rasheeddo/DynamixelServoGimbal/2AxesDynamixelServoGimbal.py

import time
from mpu6050 import mpu6050                      #new library for IMU
import math
from dynamixel_sdk import *                     # Uses Dynamixel SDK library
import threading


######################### Dynamixel Define, variable and function
ADDR_PRO_BAUDRATE           = 8

ADDR_PRO_TORQUE_ENABLE      = 64               
ADDR_PRO_GOAL_POSITION      = 116
ADDR_PRO_PRESENT_POSITION   = 132

ADDR_PRO_CURRENT_LIMIT      = 38
ADDR_PRO_GOAL_CURRENT       = 102
ADDR_PRO_PRESENT_CURRENT    = 126 

ADDR_PRO_OPERATING_MODE     = 11

ADDR_PRO_GOAL_VELOCITY      = 104

ADDR_PRO_ACCELERATION_LIMIT = 40
ADDR_PRO_VELOCITY_LIMIT     = 44
ADDR_PRO_PROFILE_ACCELERATION  = 108
ADDR_PRO_PROFILE_VELOCITY   = 112

ADDR_PRO_POSITION_D_GAIN    = 80
ADDR_PRO_POSITION_I_GAIN    = 82
ADDR_PRO_POSITION_P_GAIN    = 84
ADDR_PRO_FEEDFORWARD_2nd_GAIN = 88
ADDR_PRO_FEEDFORWARD_1st_GAIN = 90

ADDR_PRO_MOVING             = 122
ADDR_PRO_MOVING_STATUS       = 123

CURRENT_CONTROL                     = 0
POSITION_CONTROL                    = 3 # Default
CURRENT_BASED_POSITION_CONTROL      = 5
# Protocol version
PROTOCOL_VERSION            = 2.0               # See which protocol version is used in the Dynamixel

# Default setting
DXL1_ID                      = 1                             # Dynamixel ID: 1
DXL2_ID                      = 2                             # Dynamixel ID: 2
DXL3_ID                      = 3                             # Dynamixel ID: 3
DXL4_ID                      = 4
DXL5_ID                      = 5
DXL6_ID                      = 6



BAUDRATE                    = 57600            # Dynamixel default baudrate : 57600
DEVICENAME                  = '/dev/ttyUSB0'    # Check which port is being used on your controller
                                                # ex) Windows: "COM1"   Linux: "/dev/ttyUSB0" Mac: "/dev/tty.usbserial-*"
TORQUE_ENABLE               = 1                 # Value for enabling the torque
TORQUE_DISABLE              = 0                 # Value for disabling the torque

def RunServo(DEG1,DEG2):
    servo_ang1 = map(DEG1, 0.0, 360.0, 0, 4095)
    servo_ang2 = map(DEG2, 0.0, 360.0, 0, 4095)

    dxl1_goal_position = int(servo_ang1)
    dxl2_goal_position = int(servo_ang2)
    

    dxl_comm_result1, dxl_error1 = packetHandler.write4ByteTxRx(portHandler, DXL1_ID, ADDR_PRO_GOAL_POSITION, dxl1_goal_position)
    dxl_comm_result2, dxl_error2 = packetHandler.write4ByteTxRx(portHandler, DXL2_ID, ADDR_PRO_GOAL_POSITION, dxl2_goal_position)

def RunServo1(inputDeg1):
    pos1 = inputDeg1
    servo_com1 = map(pos1,0.0,360.0,0.0,4095.0)
    dxl1_goal_position = int(servo_com1)
    dxl_comm_result1, dxl_error1 = packetHandler.write4ByteTxRx(portHandler, DXL1_ID, ADDR_PRO_GOAL_POSITION, dxl1_goal_position)
    print ("RunServo1")
    if dxl_comm_result1 != COMM_SUCCESS:
        print("%s" % packetHandler.getTxRxResult(dxl_comm_result1))
    elif dxl_error1 != 0:
        print("%s" % packetHandler.getRxPacketError(dxl_error1))

def RunServo2(inputDeg2):
    pos2 = inputDeg2
    servo_com2 = map(pos2,0.0,360.0,0.0,4095.0)
    dxl2_goal_position = int(servo_com2)
    dxl_comm_result2, dxl_error2 = packetHandler.write4ByteTxRx(portHandler, DXL2_ID, ADDR_PRO_GOAL_POSITION, dxl2_goal_position)
    print ("RunServo2")
    if dxl_comm_result2 != COMM_SUCCESS:
        print("%s" % packetHandler.getTxRxResult(dxl_comm_result2))
    elif dxl_error2 != 0:
        print("%s" % packetHandler.getRxPacketError(dxl_error2))

def ReadAngle12():
    dxl_present_position1, dxl_comm_result, dxl_error = packetHandler.read4ByteTxRx(portHandler, DXL1_ID, ADDR_PRO_PRESENT_POSITION)
    dxl_present_position2, dxl_comm_result, dxl_error = packetHandler.read4ByteTxRx(portHandler, DXL2_ID, ADDR_PRO_PRESENT_POSITION)   
    pre_pos1 = map(dxl_present_position1, 0.0, 4095.0, 0.0, 360.0)
    pre_pos2 = map(dxl_present_position2, 0.0, 4095.0, 0.0, 360.0)

    return pre_pos1,pre_pos2

def GoHome12():
   
    servo_ang1 = map(140, 0.0, 360.0, 0, 4095)
    servo_ang2 = map(135, 0.0, 360.0, 0, 4095)
    

    dxl1_goal_position = servo_ang1  
    dxl2_goal_position = servo_ang2

    dxl_comm_result1, dxl_error1 = packetHandler.write4ByteTxRx(portHandler, DXL1_ID, ADDR_PRO_GOAL_POSITION, int(dxl1_goal_position))
    dxl_comm_result2, dxl_error2 = packetHandler.write4ByteTxRx(portHandler, DXL2_ID, ADDR_PRO_GOAL_POSITION, int(dxl2_goal_position))

def SetOperationMode(MODE):
    TorqueOff()
    dxl_comm_result, dxl_error = packetHandler.write1ByteTxRx(portHandler, DXL1_ID, ADDR_PRO_OPERATING_MODE, MODE)
    dxl_comm_result, dxl_error = packetHandler.write1ByteTxRx(portHandler, DXL2_ID, ADDR_PRO_OPERATING_MODE, MODE)
    
def CheckOperationMode():
    present_mode, dxl_comm_result, dxl_error = packetHandler.read1ByteTxRx(portHandler, DXL1_ID, ADDR_PRO_OPERATING_MODE)
    present_mode, dxl_comm_result, dxl_error = packetHandler.read1ByteTxRx(portHandler, DXL2_ID, ADDR_PRO_OPERATING_MODE)
    if present_mode == 0:
        # Current (Torque) Control Mode
        print("Now Operating Mode is Torque Control")
    elif present_mode == 3:
        # Position Control Mode
        print("Now Operating Mode is Position Control")
    elif present_mode == 5:
        # Current-based Position Control Mode
        print("Now Operating Mode is Current-based Position Control")
    else:
        print("In other Mode that didn't set!")

def TorqueOn():
    dxl_comm_result, dxl_error = packetHandler.write1ByteTxRx(portHandler, DXL1_ID, ADDR_PRO_TORQUE_ENABLE, TORQUE_ENABLE)
    dxl_comm_result, dxl_error = packetHandler.write1ByteTxRx(portHandler, DXL2_ID, ADDR_PRO_TORQUE_ENABLE, TORQUE_ENABLE)
    print("Enable Toruqe...")

def TorqueOff():
    dxl_comm_result, dxl_error = packetHandler.write1ByteTxRx(portHandler, DXL1_ID, ADDR_PRO_TORQUE_ENABLE, TORQUE_DISABLE)
    dxl_comm_result, dxl_error = packetHandler.write1ByteTxRx(portHandler, DXL2_ID, ADDR_PRO_TORQUE_ENABLE, TORQUE_DISABLE)
    print("Disable Toruqe...")
    

def SetProfile1(set_V_PRFL,set_A_PRFL):
    ######################### Set Velocity / Acceleration Profile  ##############################
    set_A_Limit = 32767     # 32767 default                [214.577 rev/min^2]
    set_V_Limit = 1023       # 350 Default                  [0.229RPM]

    dxl_comm_result, dxl_error = packetHandler.write4ByteTxRx(portHandler, DXL1_ID, ADDR_PRO_ACCELERATION_LIMIT, set_A_Limit)
    dxl_comm_result, dxl_error = packetHandler.write4ByteTxRx(portHandler, DXL1_ID, ADDR_PRO_VELOCITY_LIMIT, set_V_Limit)

    dxl_comm_result, dxl_error = packetHandler.write4ByteTxRx(portHandler, DXL1_ID, ADDR_PRO_PROFILE_ACCELERATION, int(set_A_PRFL))
    dxl_comm_result, dxl_error = packetHandler.write4ByteTxRx(portHandler, DXL1_ID, ADDR_PRO_PROFILE_VELOCITY, int(set_V_PRFL))

    acceleration_limit, dxl_comm_result, dxl_error = packetHandler.read4ByteTxRx(portHandler, DXL1_ID, ADDR_PRO_ACCELERATION_LIMIT)
    velocity_limit, dxl_comm_result, dxl_error = packetHandler.read4ByteTxRx(portHandler, DXL1_ID, ADDR_PRO_VELOCITY_LIMIT)

    print("V PRFL 1: %d" %set_V_PRFL)
    print("A PRFL 1: %d" %set_A_PRFL)
    print("--------------------------------")

def SetProfile2(set_V_PRFL,set_A_PRFL):
    ######################### Set Velocity / Acceleration Profile  ##############################
    set_A_Limit = 32767     # 32767 default                [214.577 rev/min^2]
    set_V_Limit = 1023      # 350 Default                  [0.229RPM]

    #set_A_PRFL = 30      # between 0 ~ set_A_limit      [214.577 rev/min^2]
    #set_V_PRFL = 200      # between 0 ~ set_V_Limit      [0.229RPM]

    dxl_comm_result, dxl_error = packetHandler.write4ByteTxRx(portHandler, DXL2_ID, ADDR_PRO_ACCELERATION_LIMIT, set_A_Limit)
    dxl_comm_result, dxl_error = packetHandler.write4ByteTxRx(portHandler, DXL2_ID, ADDR_PRO_VELOCITY_LIMIT, set_V_Limit)

    dxl_comm_result, dxl_error = packetHandler.write4ByteTxRx(portHandler, DXL2_ID, ADDR_PRO_PROFILE_ACCELERATION, int(set_A_PRFL))
    dxl_comm_result, dxl_error = packetHandler.write4ByteTxRx(portHandler, DXL2_ID, ADDR_PRO_PROFILE_VELOCITY, int(set_V_PRFL))

    acceleration_limit, dxl_comm_result, dxl_error = packetHandler.read4ByteTxRx(portHandler, DXL2_ID, ADDR_PRO_ACCELERATION_LIMIT)
    velocity_limit, dxl_comm_result, dxl_error = packetHandler.read4ByteTxRx(portHandler, DXL2_ID, ADDR_PRO_VELOCITY_LIMIT)

    print("V PRFL 2: %d" %set_V_PRFL)
    print("A PRFL 2: %d" %set_A_PRFL)
    print("--------------------------------") 

def SetPID1(set_P_Gain,set_I_Gain,set_D_Gain):
    
    dxl_comm_result, dxl_error = packetHandler.write2ByteTxRx(portHandler, DXL1_ID, ADDR_PRO_POSITION_P_GAIN, set_P_Gain)
    dxl_comm_result, dxl_error = packetHandler.write2ByteTxRx(portHandler, DXL1_ID, ADDR_PRO_POSITION_I_GAIN, set_I_Gain)
    dxl_comm_result, dxl_error = packetHandler.write2ByteTxRx(portHandler, DXL1_ID, ADDR_PRO_POSITION_D_GAIN, set_D_Gain)

    time.sleep(0.5)
    
    position_D_gain, dxl_comm_result, dxl_error = packetHandler.read2ByteTxRx(portHandler, DXL1_ID, ADDR_PRO_POSITION_D_GAIN)
    position_I_gain, dxl_comm_result, dxl_error = packetHandler.read2ByteTxRx(portHandler, DXL1_ID, ADDR_PRO_POSITION_I_GAIN)
    position_P_gain, dxl_comm_result, dxl_error = packetHandler.read2ByteTxRx(portHandler, DXL1_ID, ADDR_PRO_POSITION_P_GAIN)

    print("Position P Gain 1: %d" %position_P_gain)
    print("Position I Gain 1: %d" %position_I_gain)
    print("Position D Gain 1: %d" %position_D_gain)
    print("------------------------------")

def SetPID2(set_P_Gain,set_I_Gain,set_D_Gain):
    dxl_comm_result, dxl_error = packetHandler.write2ByteTxRx(portHandler, DXL2_ID, ADDR_PRO_POSITION_P_GAIN, set_P_Gain)
    dxl_comm_result, dxl_error = packetHandler.write2ByteTxRx(portHandler, DXL2_ID, ADDR_PRO_POSITION_I_GAIN, set_I_Gain)
    dxl_comm_result, dxl_error = packetHandler.write2ByteTxRx(portHandler, DXL2_ID, ADDR_PRO_POSITION_D_GAIN, set_D_Gain)

    time.sleep(0.5)

    position_D_gain, dxl_comm_result, dxl_error = packetHandler.read2ByteTxRx(portHandler, DXL2_ID, ADDR_PRO_POSITION_D_GAIN)
    position_I_gain, dxl_comm_result, dxl_error = packetHandler.read2ByteTxRx(portHandler, DXL2_ID, ADDR_PRO_POSITION_I_GAIN)
    position_P_gain, dxl_comm_result, dxl_error = packetHandler.read2ByteTxRx(portHandler, DXL2_ID, ADDR_PRO_POSITION_P_GAIN)

    print("Position P Gain 2: %d" %position_P_gain)
    print("Position I Gain 2: %d" %position_I_gain)
    print("Position D Gain 2: %d" %position_D_gain)
    print("------------------------------")

def SetFFGain1(set_FF1_Gain,set_FF2_Gain):
    dxl_comm_result, dxl_error = packetHandler.write2ByteTxRx(portHandler, DXL1_ID, ADDR_PRO_FEEDFORWARD_1st_GAIN, set_FF1_Gain)
    dxl_comm_result, dxl_error = packetHandler.write2ByteTxRx(portHandler, DXL1_ID, ADDR_PRO_FEEDFORWARD_2nd_GAIN, set_FF2_Gain)

    FF1_gain, dxl_comm_result, dxl_error = packetHandler.read2ByteTxRx(portHandler, DXL1_ID, ADDR_PRO_FEEDFORWARD_1st_GAIN)
    FF2_gain, dxl_comm_result, dxl_error = packetHandler.read2ByteTxRx(portHandler, DXL1_ID, ADDR_PRO_FEEDFORWARD_2nd_GAIN)

    print("Feedforward 1st Gain 1: %d" %FF1_gain)
    print("Feedforward 2nd Gain 1: %d" %FF2_gain)
    print("------------------------------") 

def SetFFGain2(set_FF1_Gain,set_FF2_Gain):
    dxl_comm_result, dxl_error = packetHandler.write2ByteTxRx(portHandler, DXL2_ID, ADDR_PRO_FEEDFORWARD_1st_GAIN, set_FF1_Gain)
    dxl_comm_result, dxl_error = packetHandler.write2ByteTxRx(portHandler, DXL2_ID, ADDR_PRO_FEEDFORWARD_2nd_GAIN, set_FF2_Gain)

    FF1_gain, dxl_comm_result, dxl_error = packetHandler.read2ByteTxRx(portHandler, DXL2_ID, ADDR_PRO_FEEDFORWARD_1st_GAIN)
    FF2_gain, dxl_comm_result, dxl_error = packetHandler.read2ByteTxRx(portHandler, DXL2_ID, ADDR_PRO_FEEDFORWARD_2nd_GAIN)

    print("Feedforward 1st Gain 2: %d" %FF1_gain)
    print("Feedforward 2nd Gain 2: %d" %FF2_gain)
    print("------------------------------")


########################## IMU define, variable 

period = 0 # initial value of period

sensor = mpu6050(0x68)

rawXoffset=0
rawYoffset=0
rawZoffset=0
rawXpoffset=0
rawYpoffset=0
rawZpoffset=0
#Variable for Kalman filter:
init=1
k_r=0.980 
k_p=0.995

Kpitch=0
Kroll=0
Kyaw=0
#Variable for the smoother function:
initSmooth=1
avPitch=[]
avRoll=[]
avYaw=[]

### Rasheed's method
init3 = 1
Dt = 0.02
global kr, kp
kr = 0.99
kp = 0.99
roll3= []
pitch3=[]

last_roll = 0
last_pitch = 0

#P_offset,R_offset = FindOffsetAngle()   

def AverageData(scale,pitch,roll):

    Buff_P = list()
    Buff_R = list()

    for i in range(0,scale):
        Buff_P.append(pitch)
        Buff_R.append(roll)

        if i == (scale-1):
            Ave_Pitch = sum(Buff_P)/len(Buff_P)
            Ave_Roll = sum(Buff_R)/len(Buff_R)
            Buff_P = list()
            Buff_R = list()

    return Ave_Pitch, Ave_Roll

def map(val, in_min, in_max, out_min, out_max):

    return (val - in_min) * (out_max - out_min) / (in_max - in_min) + out_min

def getIMU3(updateTime):
    global init3, pitch_out, roll_out
    Dt=updateTime
    acc_data = sensor.get_accel_data()
    gyro_data=sensor.get_gyro_data()

    accX=acc_data["x"]
    accY=acc_data["y"]
    accZ=acc_data["z"]
    gyroX=gyro_data["x"] - GyroXcal
    gyroY=gyro_data["y"] - GyroYcal
    gyroZ=gyro_data["z"] - GyroZcal

    #Angle calculation by axelerometer
    roll_acc = math.degrees(math.atan(accY/math.sqrt(math.pow(accX,2)+math.pow(accZ,2))))
    pitch_acc = math.degrees(math.atan(-accX/math.sqrt(math.pow(accY,2)+math.pow(accZ,2))))
    #yawA=m.degrees((m.atan(m.sqrt(m.pow(accX,2)+m.pow(accY,2)),rawZ)))
    
    if (init3):
        roll_gyro = roll_acc
        pitch_gyro = pitch_acc
        init3 = 0
    else:
        roll_gyro = Dt*gyroX + roll_out
        pitch_gyro = Dt*gyroY + pitch_out
    

    roll_out = kr*roll_gyro + (1-kr)*roll_acc
    pitch_out = kp*pitch_gyro + (1-kp)*pitch_acc
    print("Roll", roll_out)
    print("Pitch", pitch_out)
    return roll_out, pitch_out

def getRawGyro():
    giroscope_data=sensor.get_gyro_data()
    rawXp=giroscope_data["x"]
    rawYp=giroscope_data["y"]
    rawZp=giroscope_data["z"]
    return rawXp, rawYp, rawZp

def RawGyroCalibration():
    print("Doing gyro calibration...(Keep stable!)")
    gyroX = []
    gyroY = []
    gyroZ = [] 
    for i in range(0,500):
        rawGyro = getRawGyro()
        gyroX.append(rawGyro[0])
        gyroY.append(rawGyro[1])
        gyroZ.append(rawGyro[2])
        time.sleep(0.01)

    ave_gyroX = sum(gyroX)/len(gyroX)
    ave_gyroY = sum(gyroY)/len(gyroY)
    ave_gyroZ = sum(gyroZ)/len(gyroZ)

    return ave_gyroX, ave_gyroY, ave_gyroZ
   
##############################################################################
##Initialization
#Motors 
portHandler = PortHandler(DEVICENAME)
packetHandler = PacketHandler(PROTOCOL_VERSION)
if portHandler.openPort():
    print("Succeeded to open the port")
else:
    print("Failed to open the port")
    print("Press any key to terminate...")
    getch()
    quit()
if portHandler.setBaudRate(BAUDRATE):
    print("Succeeded to change the baudrate")
else:
    print("Failed to change the baudrate")
    print("Press any key to terminate...")
    getch()
    quit()
    


SetProfile1(0,0)
SetProfile2(0,0)
SetPID1(800,1000,0)
SetPID2(800,1000,0)
time.sleep(0.5)

TorqueOn()
time.sleep(0.5)
GoHome12()
time.sleep(2)

#Serial Communication
ser = serial.Serial('/dev/ttyACM0',9600)
ser.flushInput()

lastS0 = 1500
lastS1 = 1180

time.sleep(1)
#Accelerometer:
gyroCal = RawGyroCalibration()
global GyroXcal, GyroYcal, GyroZcal
GyroXcal = gyroCal[0]
GyroYcal = gyroCal[1]
GyroZcal = gyroCal[2]
#Semaphore
sem = threading.Semaphore()
mode=1180
tilt=1500

##############################################################################
#Thread functions  
def ReadSerial():
    global mode, tilt
    data=[]
    while 1:
        data = ser.readline()
        DATA = list(data)

        if len(DATA) == 11:
            DataCh1 = [DATA[0],DATA[1],DATA[2],DATA[3]]
            DataCh2 = [DATA[5],DATA[6],DATA[7],DATA[8]]
            Ch1 = "".join(DataCh1)
            Ch2 = "".join(DataCh2)
            if Ch1.isdigit() and Ch2.isdigit():
                stick = int(Ch1)
                switch = int(Ch2)
                #print ("Ch1: %d" %stick)
                #print ("Ch2: %d" %switch)
                control_ang = map(stick,1088,1920,-1.0,1.0)
                #We write in the variable protected with a semaphore
                sem.acquire()
                mode=switch
                tilt=control_ang
                sem.release()
                #print("\n")
                #print("Mode :", mode)
                #print("tilt", tilt)
                #print("\n")
            else:
                print("NA")            
        else:
            print ("Trash Data")
    #time.sleep(0.01)
            
normal_roll = 140
normal_pitch = 135
period = 0

def RunGimbal():
    global mode, tilt, period
    #Read the variable protected with a semaphore
    modeRun = 0
    tiltRun = 0
    while 1:
        startTime = time.time()
        sem.acquire()
        print("update Value")
        modeRun=mode
        tiltRun=tilt
        sem.release()
        rollDegree, pitchDegree = getIMU3(period)
        if abs(tiltRun) < 0.05:
            tiltRun = 0.00
        ## Only stabilizer mode
        if modeRun < 1200:
            #rollDegree, pitchDegree = getIMU3()
            ServoAng1 = normal_roll - rollDegree 
            ServoAng2 = normal_pitch - pitchDegree
        ## Tilt manual control
        elif modeRun > 1400 and modeRun < 1550:
            ServoAng1 = normal_roll - rollDegree 
            ServoAng2 = normal_pitch + (80*tiltRun)
            # Set new pitch angle
            new_pitch = normal_pitch + (80*tiltRun)
        ## Use new pitch angle on stabilize mode
        elif modeRun > 1800:
            #rollDegree, pitchDegree = getIMU3()
            ServoAng1 = normal_roll - rollDegree 
            ServoAng2 = new_pitch - pitchDegree
        print("Servo 1", ServoAng1)
        print("Servo 2", ServoAng2)   
        RunServo(ServoAng1,ServoAng2)

        #time.sleep(0.02)
        endTime = time.time() 
        period = endTime - startTime
        #print("Period: %f" %period)
        #print("----------------------------")

##############################################################################
#Main

#Start the thread
try:
   t1= threading.Thread(target = ReadSerial)
   t2 = threading.Thread(target = RunGimbal)
   t1.start()
   t2.start()

except:
   print("Error: unable to start thread")

while 1:
    pass
    
